tschicki/uSD2PSX/README.md

# About This Project

This variant of the [SD2PSX](https://github.com/sd2psx) is made specifically as an accessory for my [PlayStation 2](https://github.com/tschicki/PS2-Portable) portable.  
- Its electronics are based on and essentially 1:1 compatible to the original SD2PSX.  
- Form factor and pinout match an SD card, with one deviation: PS2 memory cards have an ACK signal that SD cards do not have - this is connected to pin 9, instead of DAT2.  
- While the *uSD2PSX* will fit in any SD card slot, only a PS2 will be able to access it.  
- The *uSD2PSX* may be used together with a regular PS2 console too, using a modified Bitfunx MX4SIO memory card.

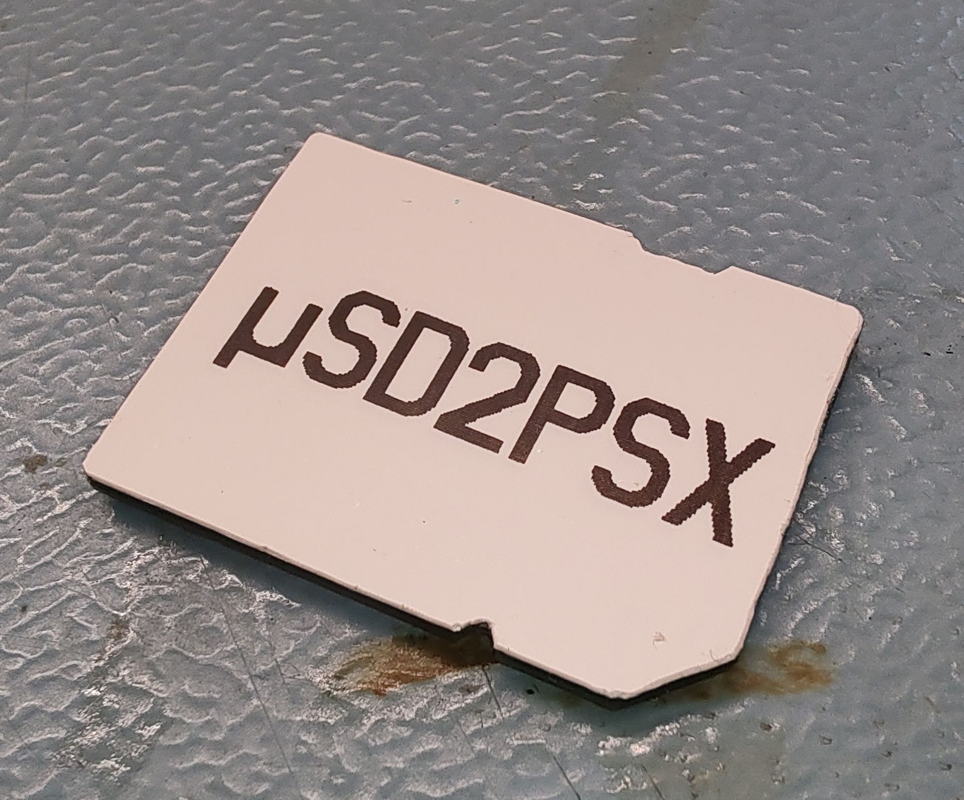
[picture p1: _img/IMG_20261030_203136353.jpg]
  
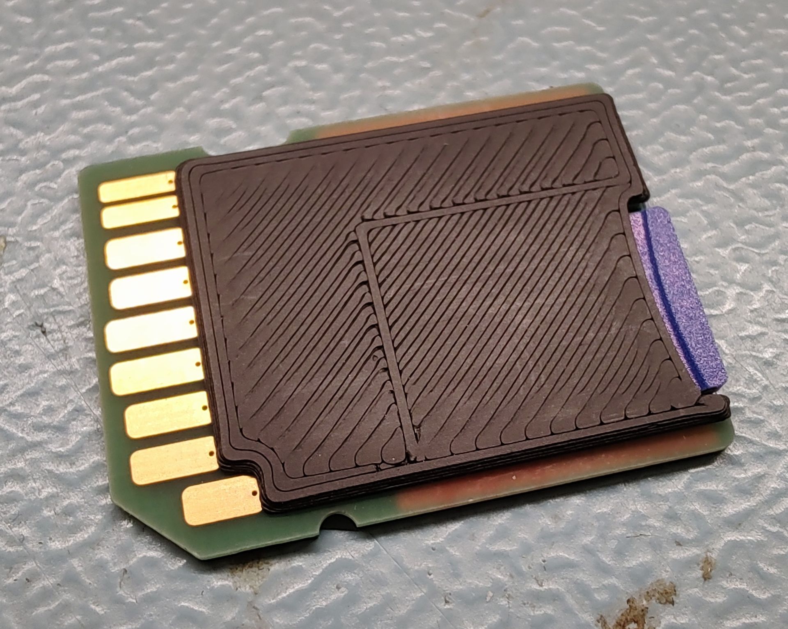
[picture p2: _img/IMG_20261029_210831415.jpg]
  

# Parts Overview
This repo contains the design files (KiCad 7 & SolidWorks Maker) and the manufacturing files for the PCBs and 3D printed parts. Below are the required components to order/print.

## uSD2PSX Base PCB
- [KiCad project](https://github.com/tschicki/uSD2PSX/tree/main/uSD2PSX_Base)
- [Gerber files](https://github.com/tschicki/uSD2PSX/tree/main/uSD2PSX_Base/Gerber)
- [BOM](https://github.com/tschicki/uSD2PSX/tree/main/uSD2PSX_Base/bom)
- Supplier: JLCPCB
- Type: 2-Layer rigid
- Thickness: 0.6mm
- Copper: 1oz
- Plating: ENIG
- Via: tented or plugged

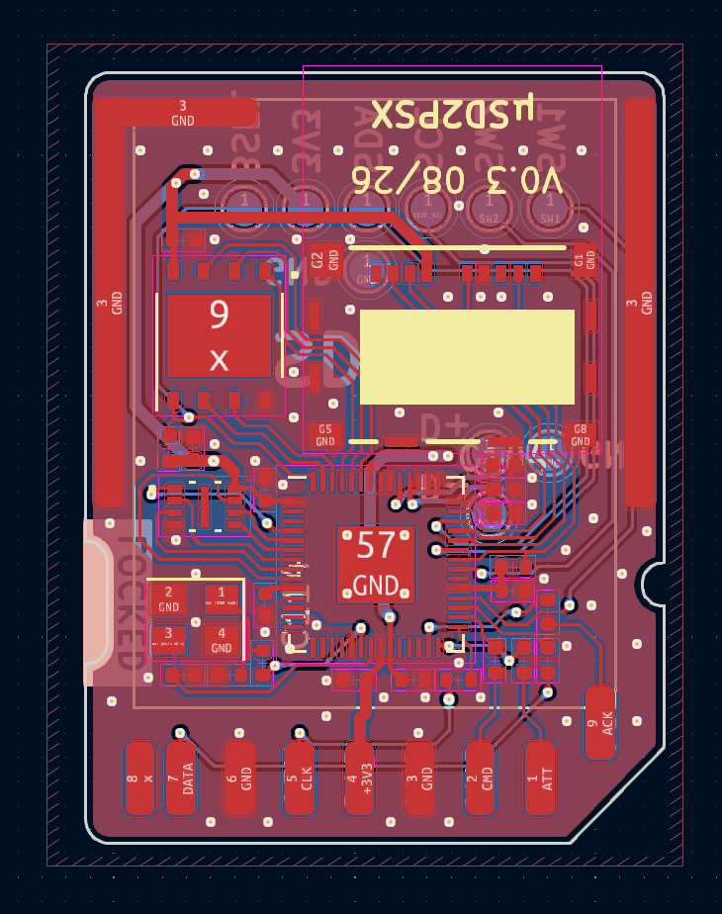
[picture p3: _img/Screenshot 2026-10-29 212916.png]
  

## uSD2PSX Contacts PCB
- [KiCad project](https://github.com/tschicki/uSD2PSX/tree/main/uSD2PSX_Contacts)
- [Gerber files](https://github.com/tschicki/uSD2PSX/tree/main/uSD2PSX_Contacts/Gerber)
- BOM: N/A
- Supplier: JLCPCB
- Type: 2-Layer rigid
- Thickness: 0.8mm
- Copper: 1oz
- Plating: ENIG
- Via: tented or plugged

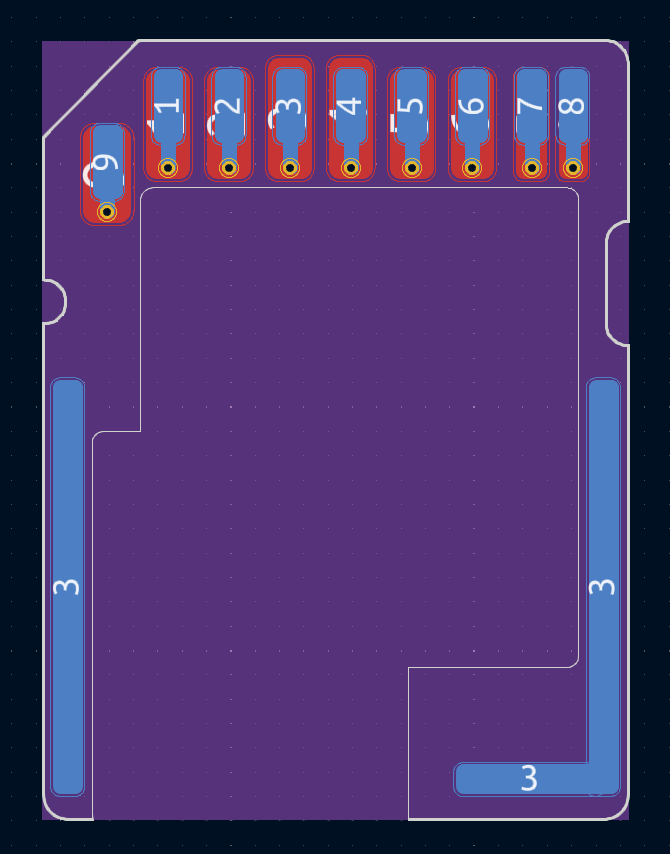
[picture p4: _img/Screenshot 2026-10-29 213000.png]
  

## uSD2PSX Needle Probe
- [KiCad project](https://github.com/tschicki/uSD2PSX/tree/main/uSD2PSX_Adapter)
- [Gerber files](https://github.com/tschicki/uSD2PSX/tree/main/uSD2PSX_Adapter/Gerber)
- [BOM](https://github.com/tschicki/uSD2PSX/tree/main/uSD2PSX_Adapter/bom)
- Supplier: JLCPCB
- Type: 2-Layer rigid
- Thickness: 1.2mm
- Copper: 1oz
- Plating: HASL
- Via: tented or plugged

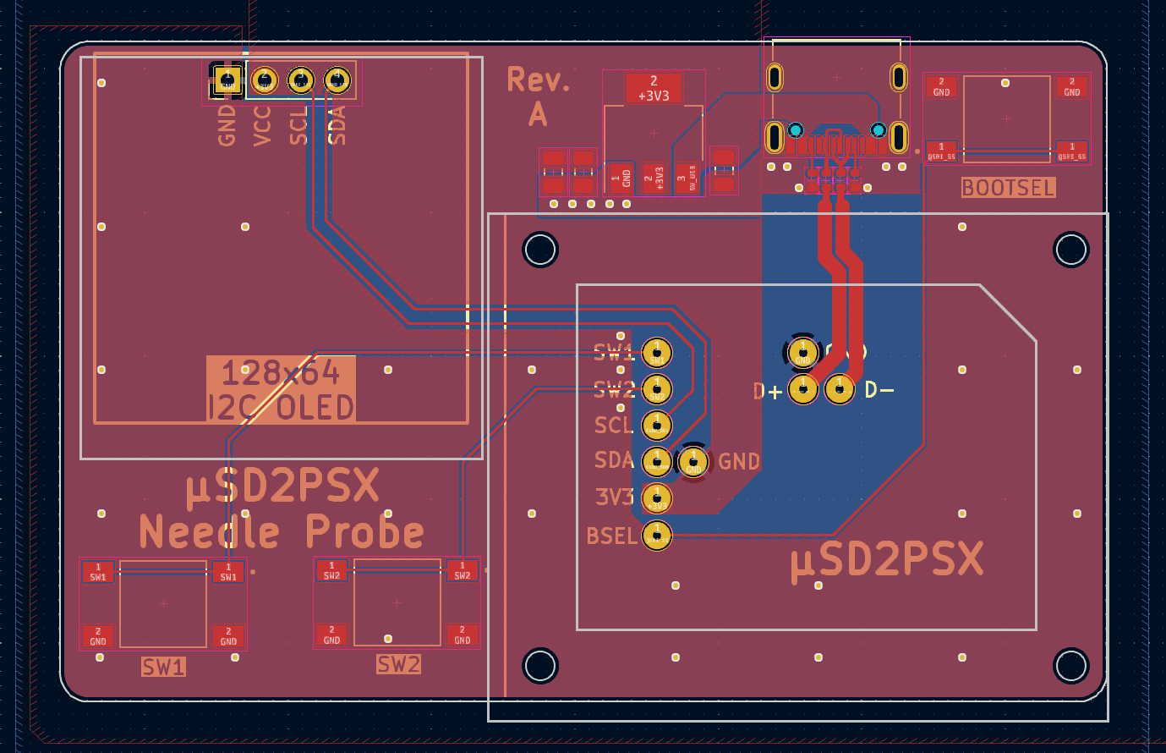
[picture p5: _img/Screenshot 2026-10-29 213052.png]
  

## uSD2PSX Cover
- [STEP & STL](https://github.com/tschicki/uSD2PSX/tree/main/uSD2PSX_3D/Export)
- 3D printed at 0.12mm layer height

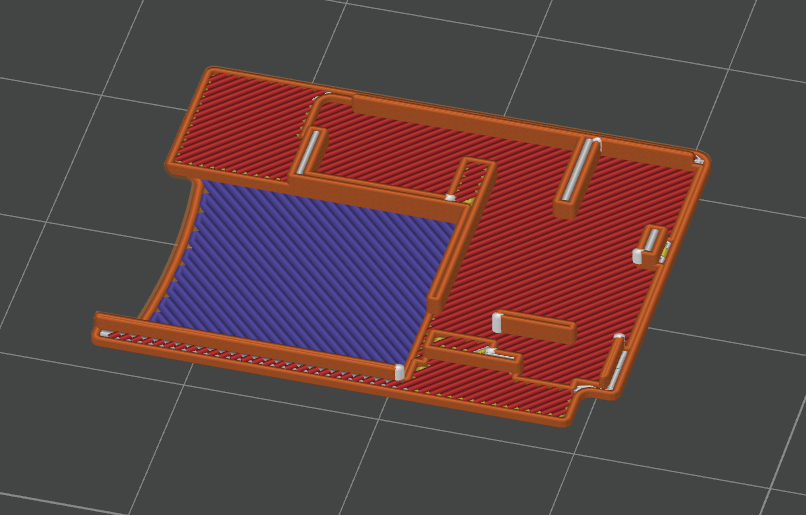
[picture p6: _img/Screenshot 2026-10-29 213247.png]
  

## uSD2PSX Needle Probe Parts
- *Clip* and *Aligner*
- [STEP & STL](https://github.com/tschicki/uSD2PSX/tree/main/uSD2PSX_3D/Export)
- 3D printed

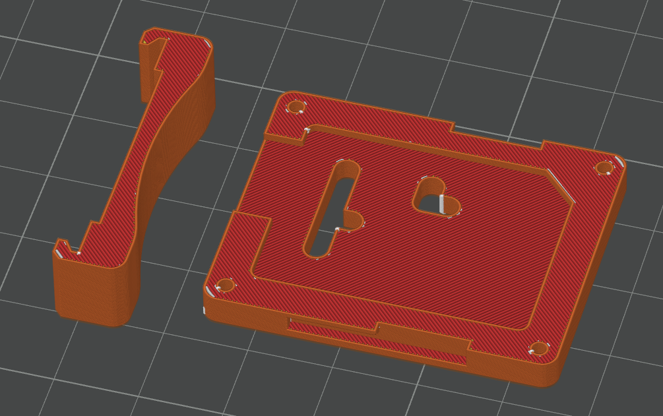
[picture p7: _img/Screenshot 2026-10-29 213211.png]
 

# Assembly uSD2PSX

## CBA Assembly
- First populate the *uSD2PSX Base* PCB according to its BOM, either manually or with stencil & paste. 
- Apply solder/paste on the pads intended for the *uSD2PSX Contacts* PCB and place it there. 
- Heat the assembly either with hot air or in a reflow oven and ensure that Base & Contacts are aligned without a gap between them.
- Check for shorts and clean the resulting assembly.

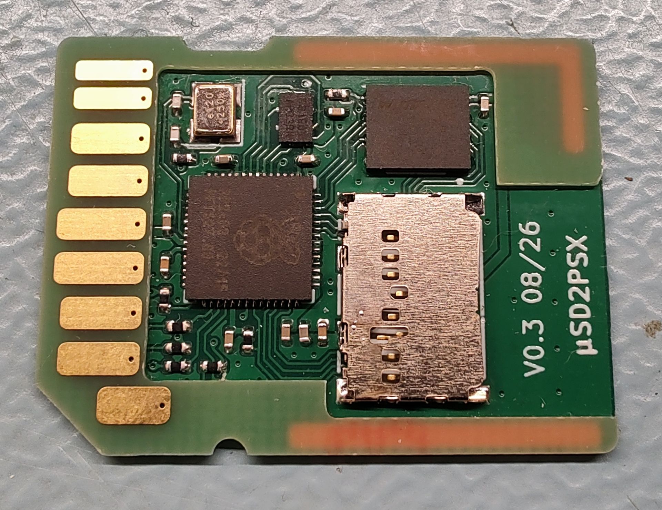
[picture p8: _img/IMG_20261029_210543881.jpg]

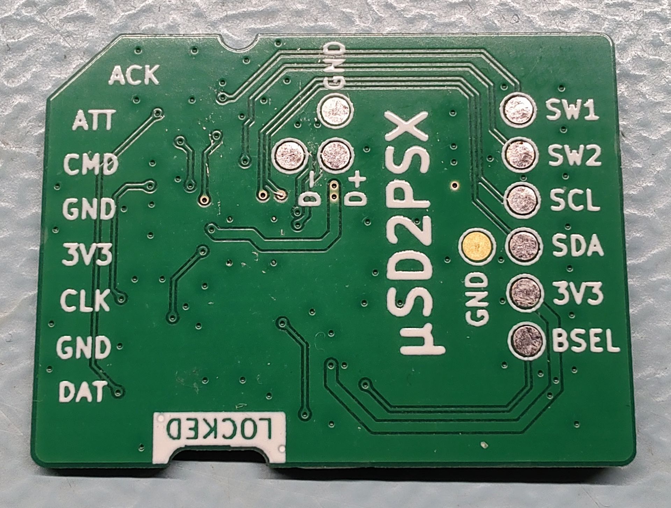
[picture p9: _img/IMG_20261029_210558447.jpg]


## SD Card Preparation
- Download the latest the SD2PSXtd firmware for SD2PSX. Find it [here](https://sd2psxtd.github.io).
- [PS2 Homebre Store](https://ps2homebrewstore.com/exploits/loadbooter-sd2psx/) has an awesome SD2PSX setup guide and pre-configured SD card image
- Prepare the SD card according to the instructions there

## Programming
- Plug the prepared micro SD card into the *uSD2PSX* assembly
- Place the assembly in the *uSD2PSX* Needle Probe and close it.
- Enter the RP2040 USB bootloader by plugging the *uSD2PSX Needle Probe* into a PC while holding the Bootsel button
- Drag the SD2PSXtd firmware image (.uf2) into the SD2PSX explorer window
- Unplug the *uSD2PSX Needle Probe*

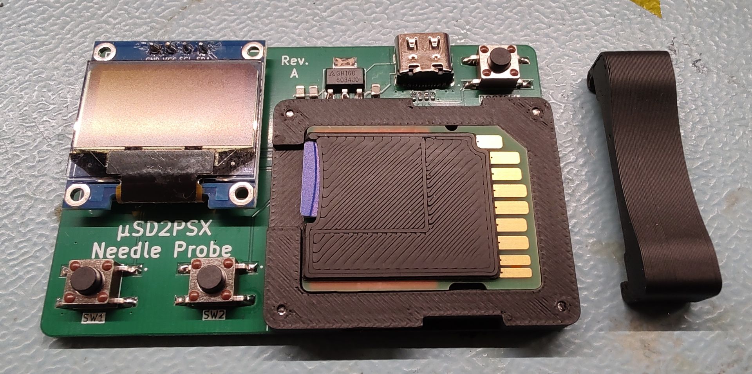
[picture p10: _img/IMG_20261029_210707560.jpg]

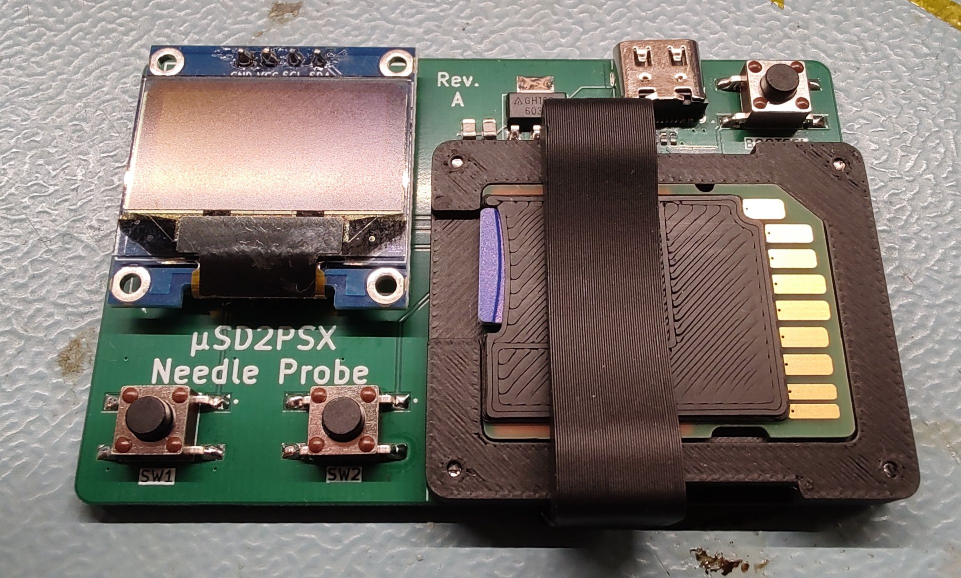
[picture p11: _img/IMG_20261029_210717275.jpg]


## Setup
- Plug the *uSD2PSX Needle Probe* back into the PC
- The OLED should now display the SD2PSX menu, use the buttons SW1 and SW2 to navigate it
- Deploy CIV.bin in the menu
- Set Autoboot=ON and Mode=PS2 in the menu
- The *uSD2PSX* should now be configured, unplug it and preferrably give it a try on a PS2
- When you are sure that the *uSD2PSX* works as intended, adhere the *uSD2PSX Cover* using 2-3 small drops of glue. Ensure that no glue enters the micro SD card slot.
- As a last step, add a sticker on the top side to protect the testpoints, it should be betwen 0.1 and 0.2mm thickness

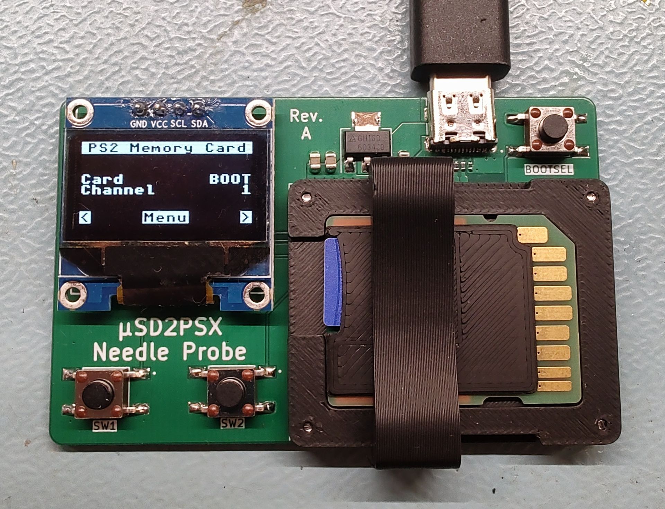
[picture p12: _img/IMG_20261029_210749547.jpg]

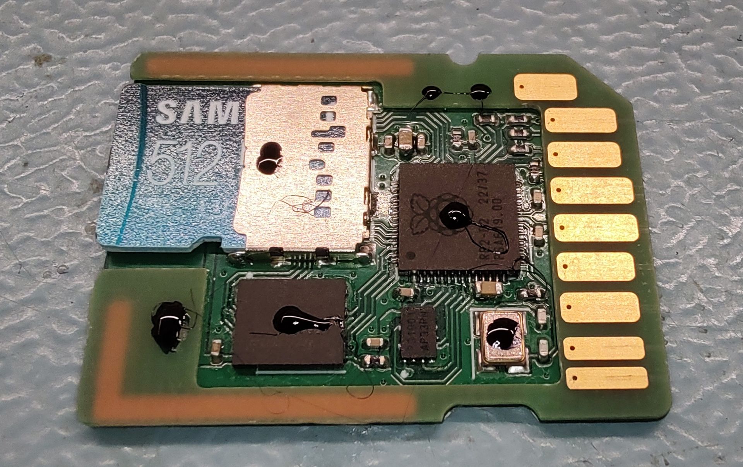
[picture p13: _img/IMG_20261030_173244812.jpg]

 

# Assembly uSD2PSX Needle Probe

- Populate the *uSD2PSX Needle Probe* CBA according to its BOM
- Clean the assembly
- Solder the 0.96 inch I2C OLED (same as SD2PSX) to the CBA
- Fix the printed Aligner to the CBA using 4 M1.6x5mm screws

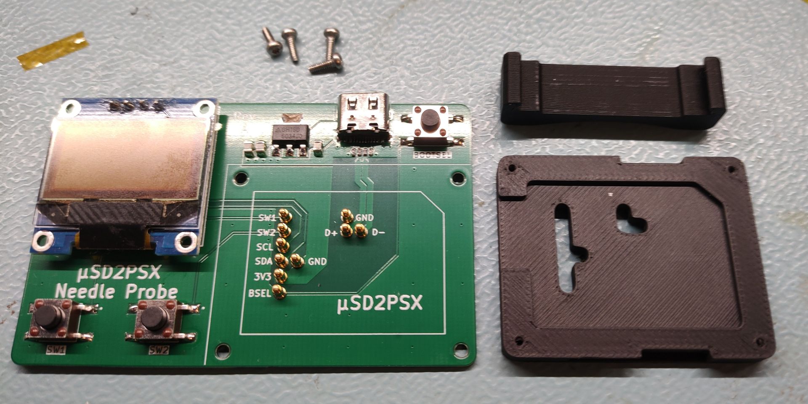
[picture p14: _img/IMG_20261029_211544140.jpg]


# Modify a MX4SIO to work with uSD2PSX

The easiest and cleanest looking way to connect the *uSD2PSX* to a stock console is to modify a Bitfunx MX4SIO adapter.  
Buy a Bitfunx MX4SIO with SD card slot (beware, they also sell micro SD versions!) and open it up.
Remove R5 and solder a wire from it to the leftmost pin of the SD card slot. This will connect the ACK signal back to its original pin.

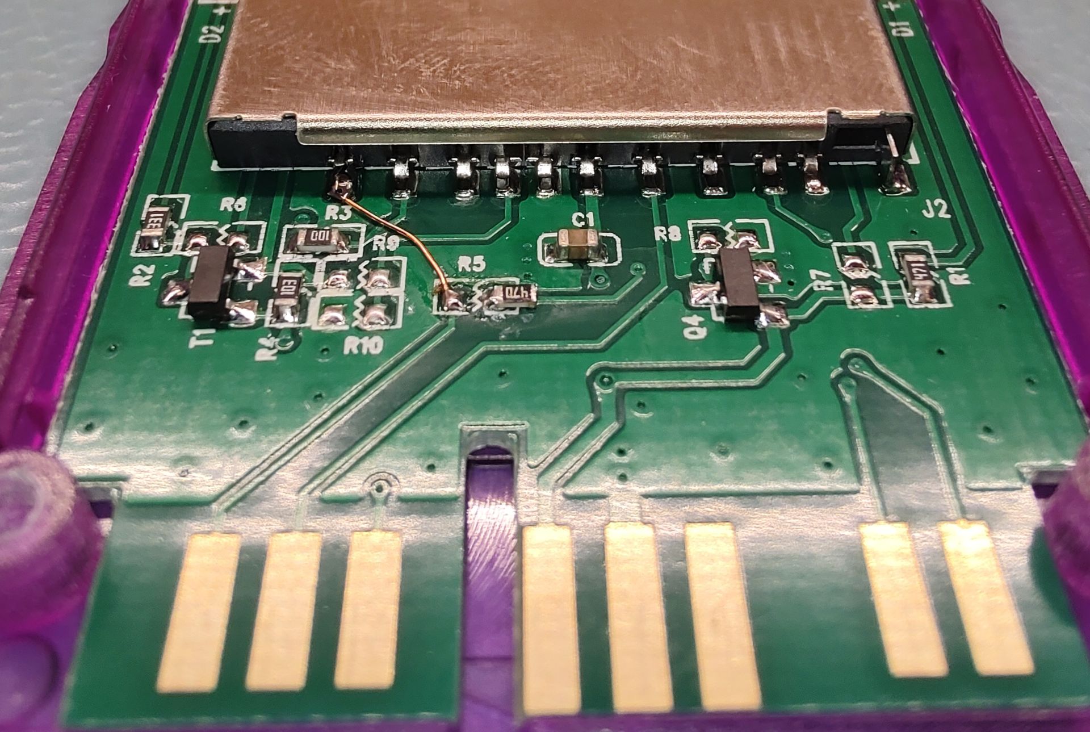
[picture p15: _img/IMG_20261029_214017485.jpg]


# Thanks!
Thanks to everyone working on SD2PSX and the awesome SD2PSXtd firmware!  
And thanks to everyone involved in [PS2 Homebre Store](https://ps2homebrewstore.com), it's awesome to see easily accessible apps and guides!
