tschicki/uSD2PSX/uSD2PSX_3D/uSD2PSX_Adapter_Assembly.SLDASM

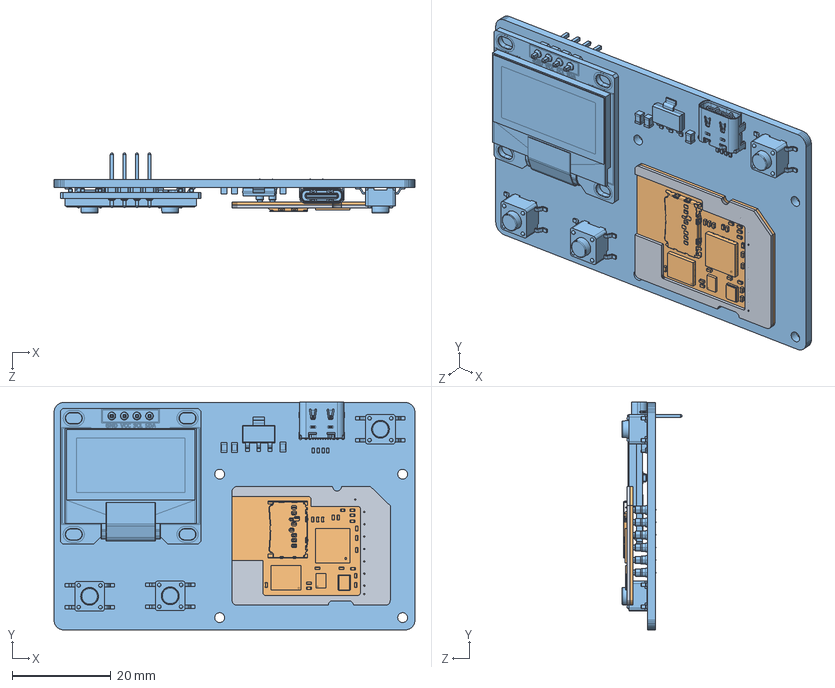
[picture p16: CAD file, 2026-10-29]
uSD2PSX_3D/uSD2PSX_Adapter_Assembly.SLDASM
73.0 x 46.1 x 12.1 mm
uSD2PSX_Needle_Probe
uSD2PSX_Base
uSD2PSX_Stiffener
