tschicki/uSD2PSX/uSD2PSX_3D/uSD2PSX_Assembly.SLDASM

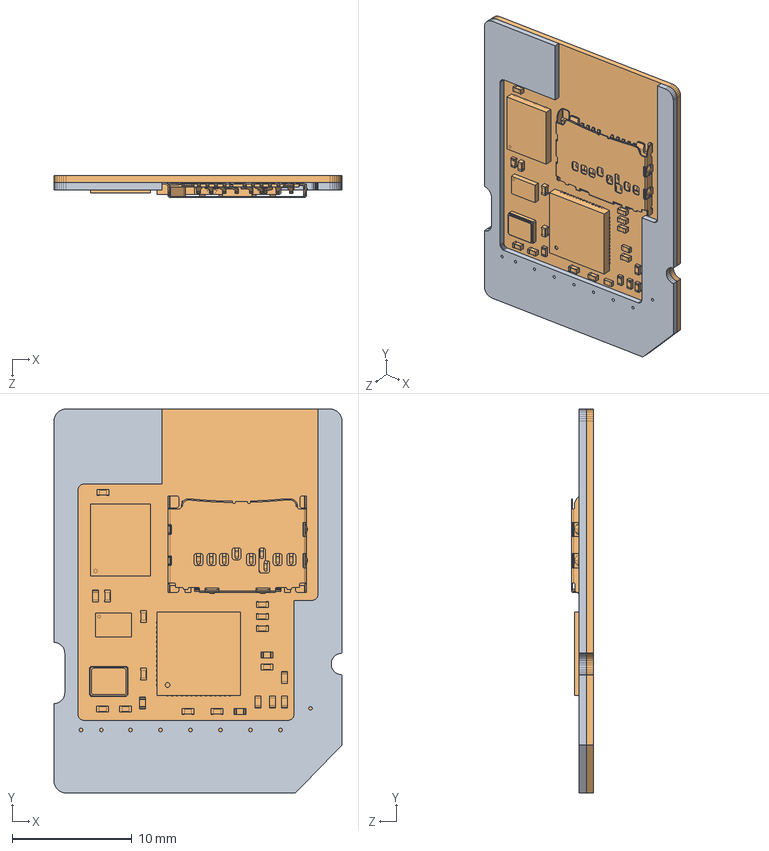
[picture p17: CAD file, 2026-10-29]
uSD2PSX_3D/uSD2PSX_Assembly.SLDASM
24.0 x 32.0 x 1.84 mm
uSD2PSX_Base
uSD2PSX_Stiffener
