tschicki/uSD2PSX/uSD2PSX_3D/Export/uSD2PSX_Clip.STEP

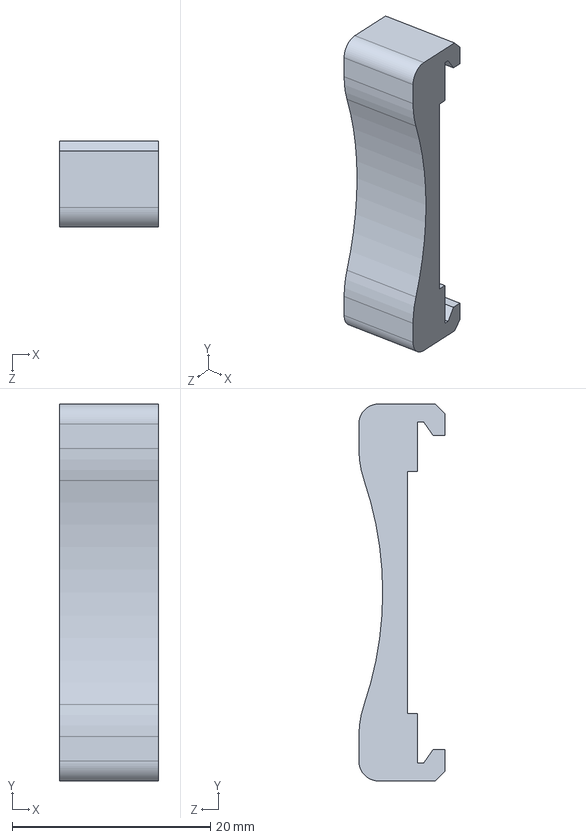
[picture p18: CAD file, 2026-10-29]
uSD2PSX_3D/Export/uSD2PSX_Clip.STEP
10.00 x 38.0 x 8.70 mm
