tschicki/uSD2PSX/uSD2PSX_3D/uSD2PSX_Needle_Probe.SLDPRT

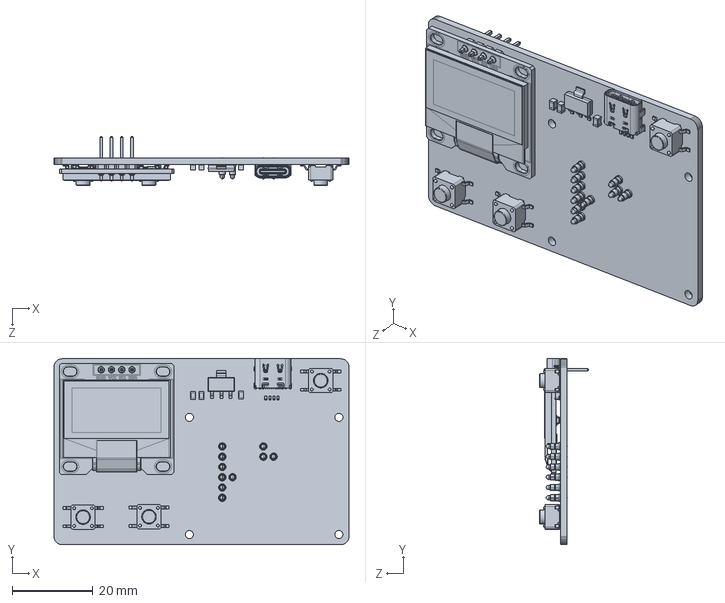
[picture p19: CAD file, 2026-10-29]
uSD2PSX_3D/uSD2PSX_Needle_Probe.SLDPRT
73.0 x 46.1 x 12.1 mm
