tschicki/uSD2PSX/uSD2PSX_3D/Export/uSD2PSX_Aligner.STEP

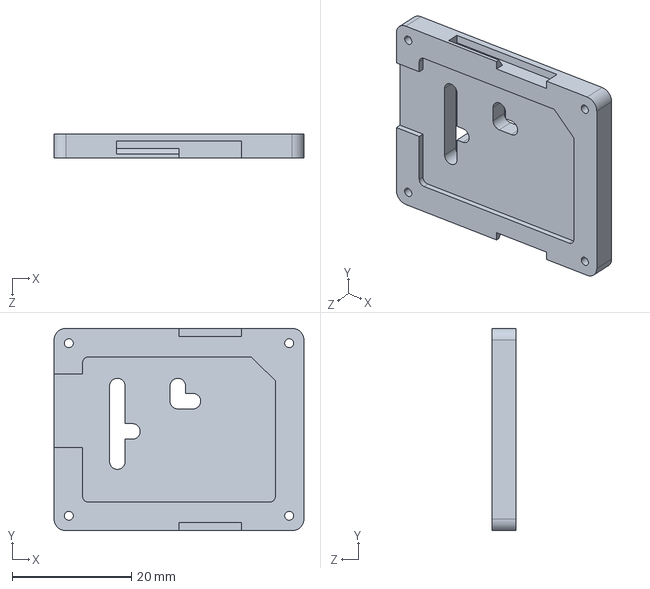
[picture p20: CAD file, 2026-10-29]
uSD2PSX_3D/Export/uSD2PSX_Aligner.STEP
42.0 x 34.0 x 4.00 mm
