tschicki/uSD2PSX/uSD2PSX_3D/uSD2PSX_Base.SLDPRT

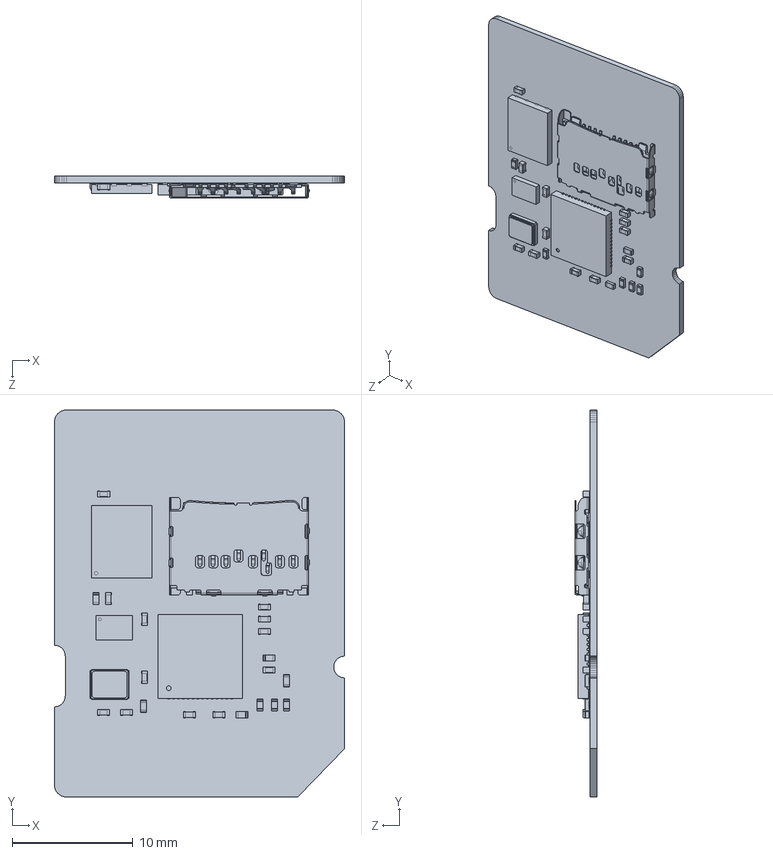
[picture p21: CAD file, 2026-10-29]
uSD2PSX_3D/uSD2PSX_Base.SLDPRT
24.0 x 32.0 x 1.84 mm
