tschicki/uSD2PSX/uSD2PSX_3D/Export/uSD2PSX_Cover.STEP

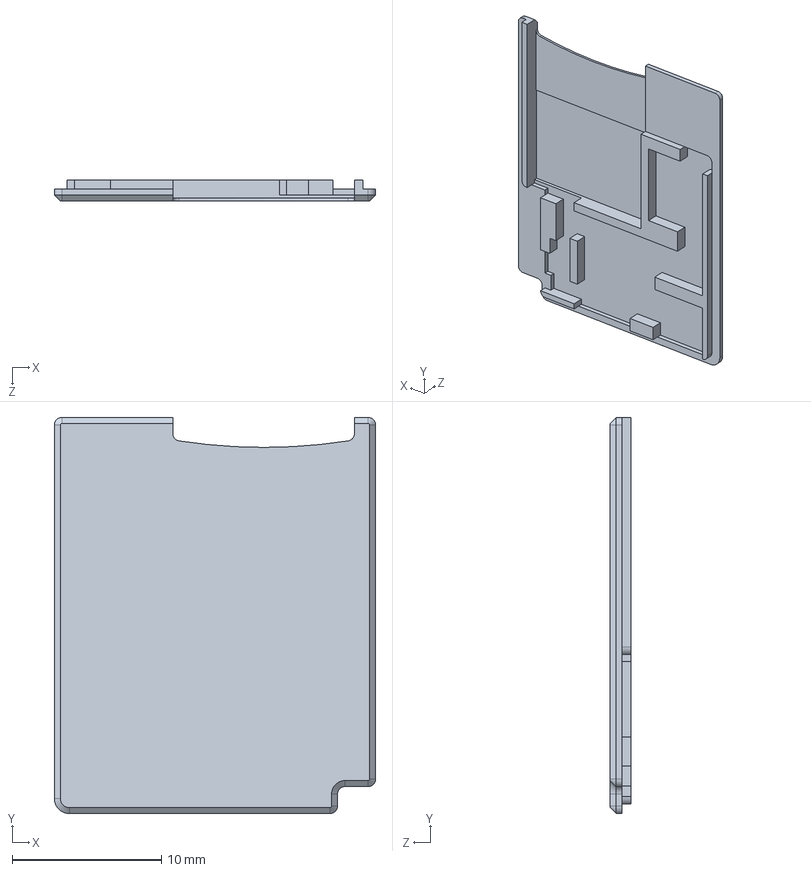
[picture p22: CAD file, 2026-10-29]
uSD2PSX_3D/Export/uSD2PSX_Cover.STEP
21.5 x 26.5 x 1.40 mm
