tschicki/uSD2PSX/uSD2PSX_3D/uSD2PSX_Stiffener.SLDPRT

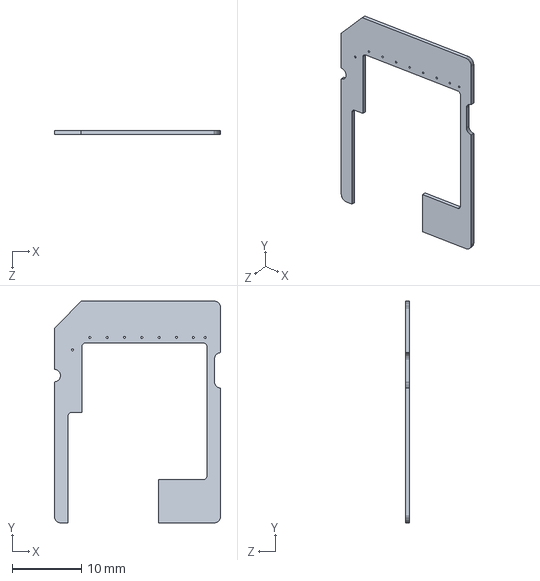
[picture p23: CAD file, 2026-10-29]
uSD2PSX_3D/uSD2PSX_Stiffener.SLDPRT
24.0 x 32.0 x 0.6 mm
