tschicki/uSD2PSX/(list of files, cad)

Other CAD files:
uSD2PSX_3D/Export/uSD2PSX_Aligner.STL
uSD2PSX_3D/Export/uSD2PSX_Clip.STL
uSD2PSX_3D/Export/uSD2PSX_Cover.STL
uSD2PSX_3D/uSD2PSX_Aligner.SLDPRT
uSD2PSX_3D/uSD2PSX_Cover.SLDPRT
