tschicki/uSD2PSX/uSD2PSX_Base/uSD2PSX_Base.kicad_pcb

## KiCad design uSD2PSX_Base/uSD2PSX_Base.kicad_pcb (2026-10-29)

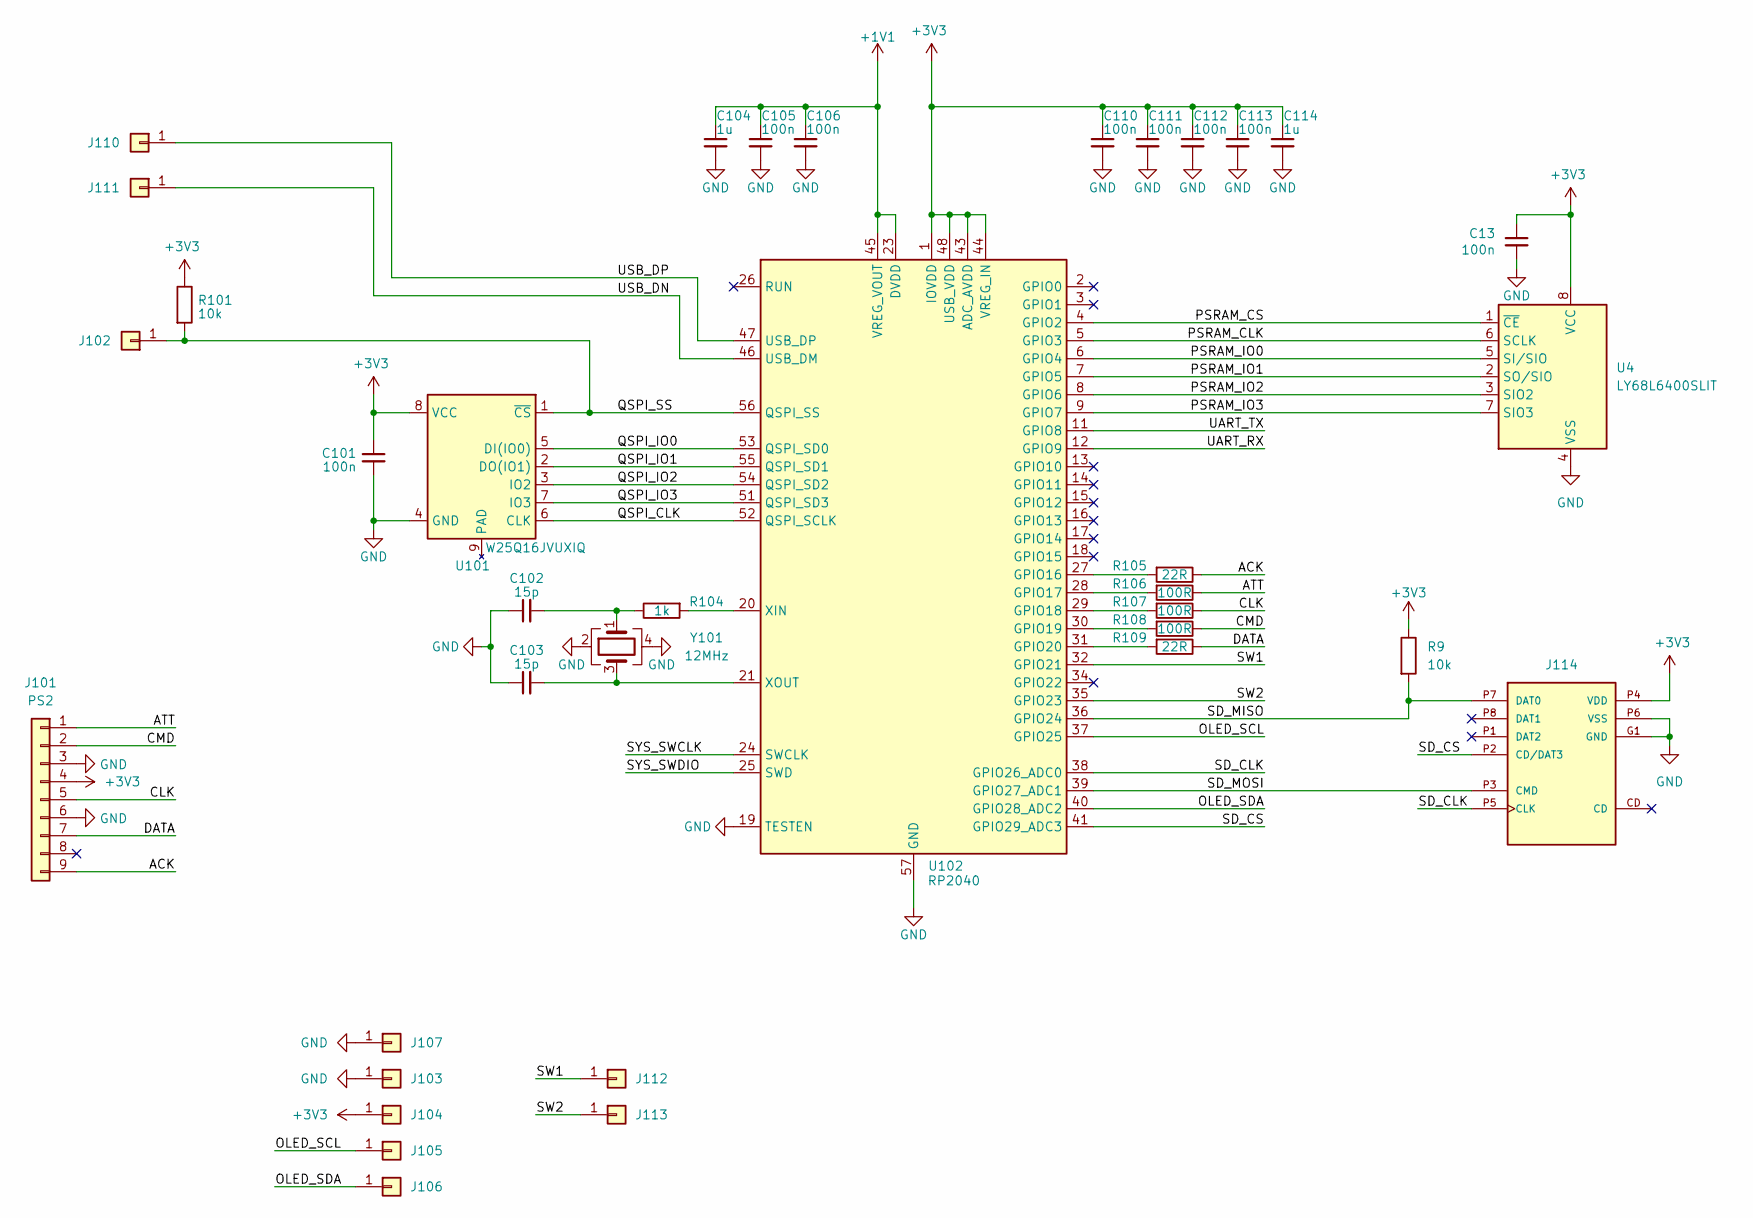
[picture p24: schematic uSD2PSX_Base.kicad_sch]

Parts:
C13, C101, C105, C106, C110, C111, C112, C113: 100n; C_0402_1005Metric; Part Number CC0402KRX7R7BB104
C102, C103: 15p; C_0402_1005Metric; Part Number CC0402JRNPO9BN150
C104, C114: 1u; C_0402_1005Metric; Part Number CC0603KRX7R7BB105
J101: PS2; uSD2PSX_Base
J102: BSEL; TestPoint_Pad_D1.5mm
J103, J107, J112: GND; TestPoint_Pad_D1.5mm
J104, J113: 3V3; TestPoint_Pad_D1.5mm
J105: SCL; TestPoint_Pad_D1.5mm
J106: SDA; TestPoint_Pad_D1.5mm
J110: DP; TestPoint_Pad_D1.5mm
J111: DN; TestPoint_Pad_D1.5mm
J114: MEM2085-00-115-00-A_REV0.2; GCT_MEM2085-00-115-00-A_REV0.2; Part Number MEM2085-00-115-00-A
R9, R101: 10k; R_0402_1005Metric; Part Number RC0402JR-0710KL
R104: 1k; R_0402_1005Metric; Part Number RC0402FR-071KL
R105, R109: 22R; R_0402_1005Metric; Part Number RC0402FR-0722RL
R106, R107, R108: 100R; R_0402_1005Metric; Part Number RC0402JR-07100RL
U4: LY68L6400SLIT; IC_W25Q16JVUXIQ_TR; Part Number APS6404L-3SQR-ZR; LCSC C261881
U101: W25Q16JVUXIQ; WSON-8-1EP_6x5mm_P1.27mm_EP3.4x4.3mm; Part Number W25Q16JVUXIQ TR
U102: RP2040; QFN-56-1EP_7x7mm_P0.4mm_EP3.2x3.2mm; Part Number RP2040
Y101: 12MHz; Crystal_SMD_3225-4Pin_3.2x2.5mm; Part Number FL1200112

Connections:
+1V1: C104.1, C105.1, C106.1, U102.23 (DVDD), U102.45 (VREG_VOUT), U102.50 (DVDD)
+3V3: C13.1, C101.1, C110.1, C111.1, C112.1, C113.1, C114.1, J101.4, J104.1, J114.P4 (VDD), R9.1, R101.1, U4.8 (VCC), U101.8 (VCC), U102.1 (IOVDD), U102.10 (IOVDD), U102.22 (IOVDD), U102.33 (IOVDD), U102.42 (IOVDD), U102.43 (ADC_AVDD), U102.44 (VREG_IN), U102.48 (USB_VDD), U102.49 (IOVDD)
/ACK: J101.9, R105.1
/ATT: J101.1, R106.1
/CLK: J101.5, R107.1
/CMD: J101.2, R108.1
/DATA: J101.7, R109.1
/OLED_SCL: J105.1, U102.37 (GPIO25)
/OLED_SDA: J106.1, U102.40 (GPIO28_ADC2)
/PSRAM_CLK: U4.6 (SCLK), U102.5 (GPIO3)
/PSRAM_CS: U4.1 (~CE), U102.4 (GPIO2)
/PSRAM_IO0: U4.5 (SI/SIO), U102.6 (GPIO4)
/PSRAM_IO1: U4.2 (SO/SIO), U102.7 (GPIO5)
/PSRAM_IO2: U4.3 (SIO2), U102.8 (GPIO6)
/PSRAM_IO3: U4.7 (SIO3), U102.9 (GPIO7)
/QSPI_CLK: U101.6 (CLK), U102.52 (QSPI_SCLK)
/QSPI_IO0: U101.5 (DI(IO0)), U102.53 (QSPI_SD0)
/QSPI_IO1: U101.2 (DO(IO1)), U102.55 (QSPI_SD1)
/QSPI_IO2: U101.3 (IO2), U102.54 (QSPI_SD2)
/QSPI_IO3: U101.7 (IO3), U102.51 (QSPI_SD3)
/QSPI_SS: J102.1, R101.2, U101.1 (~CS), U102.56 (QSPI_SS)
/SD_CLK: J114.P5 (CLK), U102.38 (GPIO26_ADC0)
/SD_CS: J114.P2 (CD/DAT3), U102.41 (GPIO29_ADC3)
/SD_MISO: J114.P7 (DAT0), R9.2, U102.36 (GPIO24)
/SD_MOSI: J114.P3 (CMD), U102.39 (GPIO27_ADC1)
/SW1: J112.1, U102.32 (GPIO21)
/SW2: J113.1, U102.35 (GPIO23)
/SYS_SWCLK: U102.24 (SWCLK)
/SYS_SWDIO: U102.25 (SWD)
/UART_RX: U102.12 (GPIO9)
/UART_TX: U102.11 (GPIO8)
/USB_DN: J111.1, U102.46 (USB_DM)
/USB_DP: J110.1, U102.47 (USB_DP)
GND: C13.2, C101.2, C102.1, C103.1, C104.2, C105.2, C106.2, C110.2, C111.2, C112.2, C113.2, C114.2, J101.3, J101.6, J103.1, J107.1, J114.G1 (GND), J114.G2 (GND__1), J114.G3 (GND__2), J114.G4 (GND__3), J114.G5 (GND__4), J114.G6 (GND__5), J114.G7 (GND__6), J114.G8 (GND__7), J114.G9 (GND__8), J114.G10 (GND__9), J114.P6 (VSS), U4.4 (VSS), U101.4 (GND), U102.19 (TESTEN), U102.57 (GND), Y101.2, Y101.4
unnamed: C102.2, R104.1, Y101.1
unnamed: R105.2, U102.27 (GPIO16)
unnamed: R106.2, U102.28 (GPIO17)
unnamed: R107.2, U102.29 (GPIO18)
unnamed: R108.2, U102.30 (GPIO19)
unnamed: R109.2, U102.31 (GPIO20)
unnamed: R104.2, U102.20 (XIN)
unnamed: C103.2, U102.21 (XOUT), Y101.3

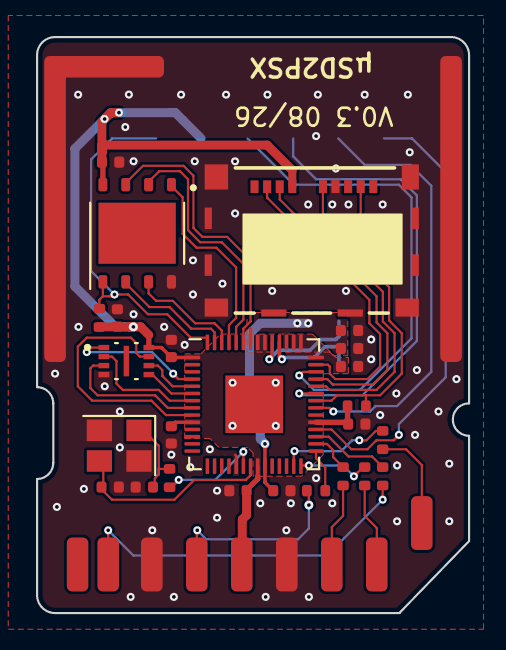
[picture p25: board uSD2PSX_Base.kicad_pcb from above]

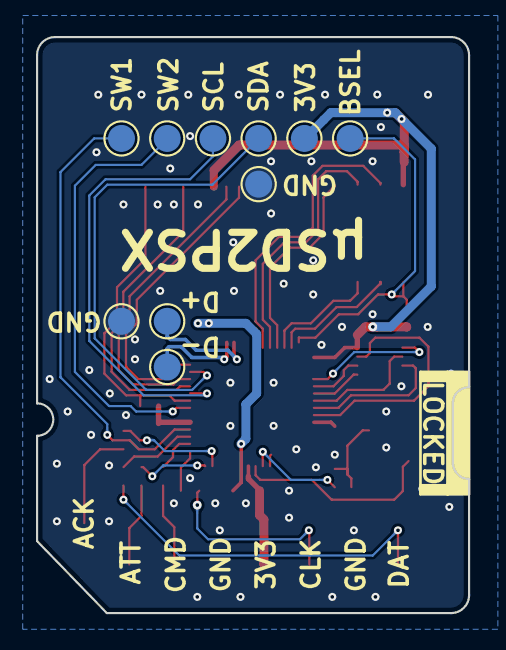
[picture p26: board uSD2PSX_Base.kicad_pcb from below]

Board: 2 copper layers, 24.0 x 32.0 mm, 36 parts (11 on the bottom side), 38 nets.
